yuntsebaryon/AtlasScientificSensorArduino/(list of files, drawings)

Other design files:
PCB/TeensyHumO2TC/freerouting.dsn
PCB/TeensyHumO2TC/temp-freerouting.dsn
