yuntsebaryon/AtlasScientificSensorArduino/PCB/TeensyHumO2TC/TeensyHumO2TC.kicad_pcb

## KiCad design PCB/TeensyHumO2TC/TeensyHumO2TC.kicad_pcb (2023-09-07)

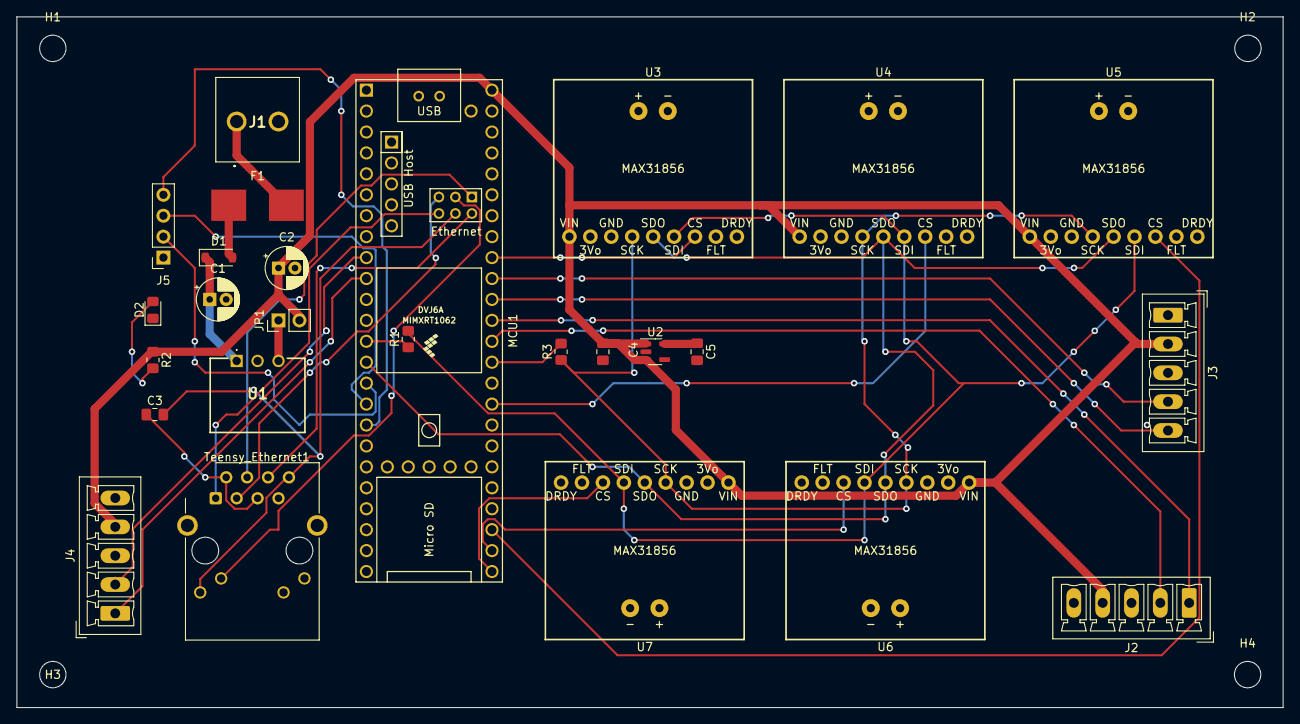
[picture p1: board TeensyHumO2TC.kicad_pcb from above]

Board: 2 copper layers, 153.7 x 83.8 mm, 30 parts (0 on the bottom side), 28 nets.

Parts:
C1: 10u; CP_Radial_D5.0mm_P2.00mm
C2: 22u; CP_Radial_D5.0mm_P2.00mm
C3: 100n; C_0805_2012Metric_Pad1.18x1.45mm_HandSolder
C4, C5: 1u; C_0805_2012Metric_Pad1.18x1.45mm_HandSolder
D1: D; D_SOD-123
D2: LED 5VOK; LED_0805_2012Metric_Pad1.15x1.40mm_HandSolder
F1: 1A; smd_fuse
H1, H2, H3, H4: MountingHole; MountingHole_3.2mm_M3_DIN965
J1: Screw_Terminal_01x02; TB00750802BE
J2, J3, J4: Conn_01x05_Socket; PhoenixContact_MCV_1,5_5-G-3.5_1x05_P3.50mm_Vertical
J5: OLED Display I2C; PinSocket_1x04_P2.54mm_Vertical
JP1: PS; PinHeader_1x02_P2.54mm_Vertical
MCU1: Teensy41
R1, R3: 22R; R_0805_2012Metric_Pad1.20x1.40mm_HandSolder
R2: 1.5k; R_0805_2012Metric_Pad1.20x1.40mm_HandSolder
Teensy_Ethernet1: RJ45_Cetus_J1B1211CCD_Horizontal
U1: N7805; N78051C
U2: NCP163ASN330T1G; SOT-23-5
U3, U4, U5, U6, U7: thermo_max31856; MAX31856

Connections:
+3.3VA: C5.1, U2.5 (VOUT)
+5V: C2.1, C4.1, J2.4, J3.2, J4.4, JP1.2 (B), MCU1.48 (VIN), R2.1, U2.1 (VIN), U2.3 (EN), U3.1 (VIN), U4.1 (VIN), U5.1 (VIN), U6.1 (VIN), U7.1 (VIN)
/CLK: R3.1, U3.4 (SCK), U4.4 (SCK), U5.4 (SCK), U6.4 (SCK), U7.4 (SCK)
/CS_1: MCU1.40 (18_A4_SDA), U3.7 (CS)
/CS_2: MCU1.33 (41_A17), U4.7 (CS)
/CS_3: MCU1.27 (35_TX8), U5.7 (CS)
/CS_4: MCU1.26 (34_RX8), U6.7 (CS)
/CS_5: MCU1.25 (33_MCLK2), U7.7 (CS)
/SDI: R1.2, U3.6 (SDI), U4.6 (SDI), U5.6 (SDI), U6.6 (SDI), U7.6 (SDI)
/SDO: MCU1.14 (12_MISO_MQSL), U3.5 (SDO), U4.5 (SDO), U5.5 (SDO), U6.5 (SDO), U7.5 (SDO)
GND: C1.2, C2.2, C4.2, C5.2, D2.1 (K), J1.2, J2.3, J2.5, J3.1, J3.3, J4.3, J4.5, J5.1, MCU1.47 (GND), U1.2 (GND/-Vout), U2.2 (GND), U3.3 (GND), U4.3 (GND), U5.3 (GND), U6.3 (GND), U7.3 (GND)
I2C_SCL: J5.3, MCU1.16 (24_A10_TX6_SCL2)
I2C_SDA: J5.4, MCU1.17 (25_A11_RX6_SDA2)
unnamed: C3.1, Teensy_Ethernet1.2, Teensy_Ethernet1.5
unnamed: C3.2, MCU1.64 (GND), Teensy_Ethernet1.8, Teensy_Ethernet1.9
unnamed: D1.2 (A), F1.1
unnamed: C1.1, D1.1 (K), U1.1 (IN)
unnamed: D2.2 (A), R2.2
unnamed: F1.2, J1.1
unnamed: J5.2, MCU1.15 (3V3)
unnamed: JP1.1 (A), U1.3 (+Vout/GND)
unnamed: MCU1.13 (11_MOSI_CTX1), R1.1
unnamed: MCU1.35 (13_SCK_LED), R3.2
unnamed: MCU1.61 (LED), Teensy_Ethernet1.10
unnamed: MCU1.60 (R+), Teensy_Ethernet1.4
unnamed: MCU1.65 (R-), Teensy_Ethernet1.6
unnamed: MCU1.63 (T+), Teensy_Ethernet1.1
unnamed: MCU1.62 (T-), Teensy_Ethernet1.3
