yuntsebaryon/AtlasScientificSensorArduino/PCB/HumidityO2/HumidityO2.kicad_pcb

## KiCad design PCB/HumidityO2/HumidityO2.kicad_pcb (2023-05-11)

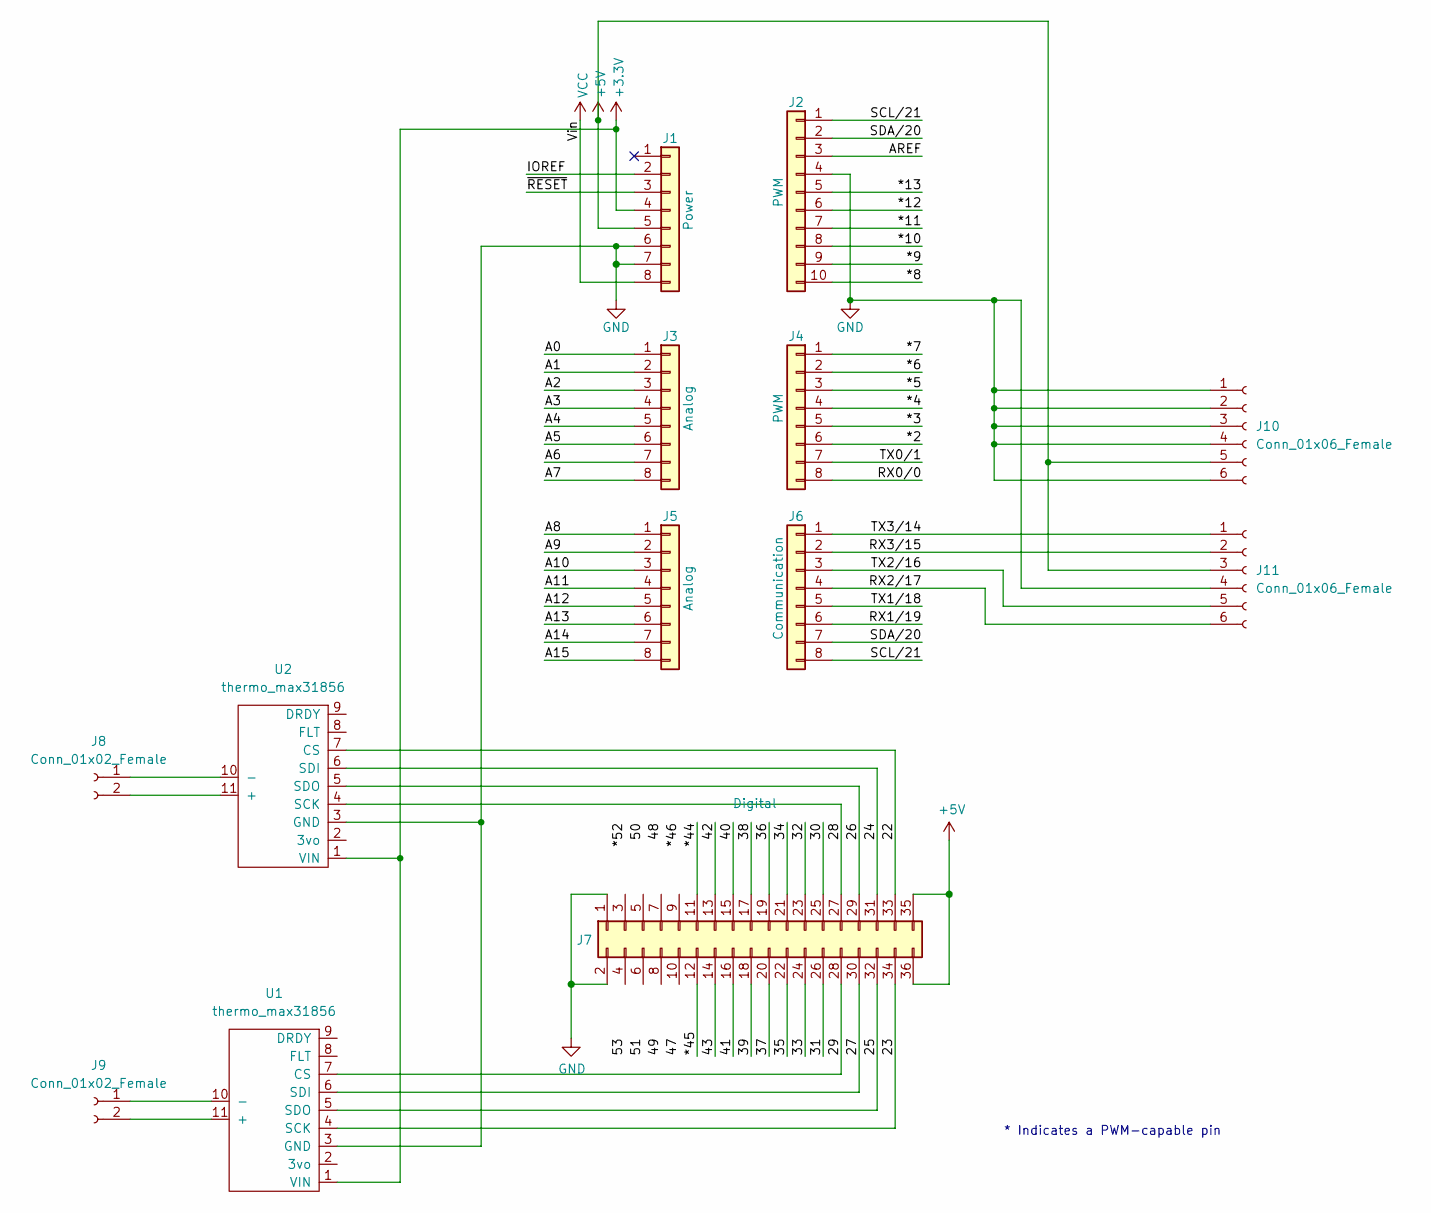
[picture p2: schematic HumidityO2.kicad_sch]

Parts:
J1: Power; PinSocket_1x08_P2.54mm_Vertical
J2: PWM; PinSocket_1x10_P2.54mm_Vertical
J3, J5: Analog; PinSocket_1x08_P2.54mm_Vertical
J4: PWM; PinSocket_1x08_P2.54mm_Vertical
J6: Communication; PinSocket_1x08_P2.54mm_Vertical
J7: Digital; PinSocket_2x18_P2.54mm_Vertical
J8, J9: Conn_01x02_Female; PhoenixContact_MCV_1,5_2-G-3.5_1x02_P3.50mm_Vertical
J10, J11: Conn_01x06_Female; PhoenixContact_MCV_1,5_6-G-3.5_1x06_P3.50mm_Vertical
U1, U2: thermo_max31856; MAX31856

Connections:
+3V3: J1.4, U1.1 (VIN), U2.1 (VIN)
+5V: J1.5, J7.35, J7.36, J10.5, J11.3
/22: J7.33, U2.7 (CS)
/23: J7.34, U1.4 (SCK)
/24: J7.31, U2.6 (SDI)
/25: J7.32, U1.5 (SDO)
/26: J7.29, U2.5 (SDO)
/27: J7.30, U1.6 (SDI)
/28: J7.27, U2.4 (SCK)
/29: J7.28, U1.7 (CS)
/30: J7.25
/31: J7.26
/32: J7.23
/33: J7.24
/34: J7.21
/35: J7.22
/36: J7.19
/37: J7.20
/38: J7.17
/39: J7.18
/40: J7.15
/41: J7.16
/42: J7.13
/43: J7.14
/*2: J4.6
/*3: J4.5
/*4: J4.4
/*5: J4.3
/*6: J4.2
/*7: J4.1
/*8: J2.10
/*9: J2.9
/*10: J2.8
/*11: J2.7
/*12: J2.6
/*13: J2.5
/*44: J7.11
/*45: J7.12
/A0: J3.1
/A1: J3.2
/A2: J3.3
/A3: J3.4
/A4: J3.5
/A5: J3.6
/A6: J3.7
/A7: J3.8
/A8: J5.1
/A9: J5.2
/A10: J5.3
/A11: J5.4
/A12: J5.5
/A13: J5.6
/A14: J5.7
/A15: J5.8
/AREF: J2.3
/IOREF: J1.2
/RX0/0: J4.8
/RX1/19: J6.6
/RX2/17: J6.4, J11.6
/RX3/15: J6.2, J11.2
/SCL/21: J2.1, J6.8
/SDA/20: J2.2, J6.7
/TX0/1: J4.7
/TX1/18: J6.5
/TX2/16: J6.3, J11.5
/TX3/14: J6.1, J11.1
/~RESET: J1.3
GND: J1.6, J1.7, J2.4, J7.1, J7.2, J10.1, J10.2, J10.3, J10.4, J10.6, J11.4, U1.3 (GND), U2.3 (GND)
unnamed: J8.1, U2.10 (-)
unnamed: J8.2, U2.11 (+)
unnamed: J9.1, U1.10 (-)
unnamed: J9.2, U1.11 (+)
VCC: J1.8

Notes on the sheet:
* Indicates a PWM-capable pin

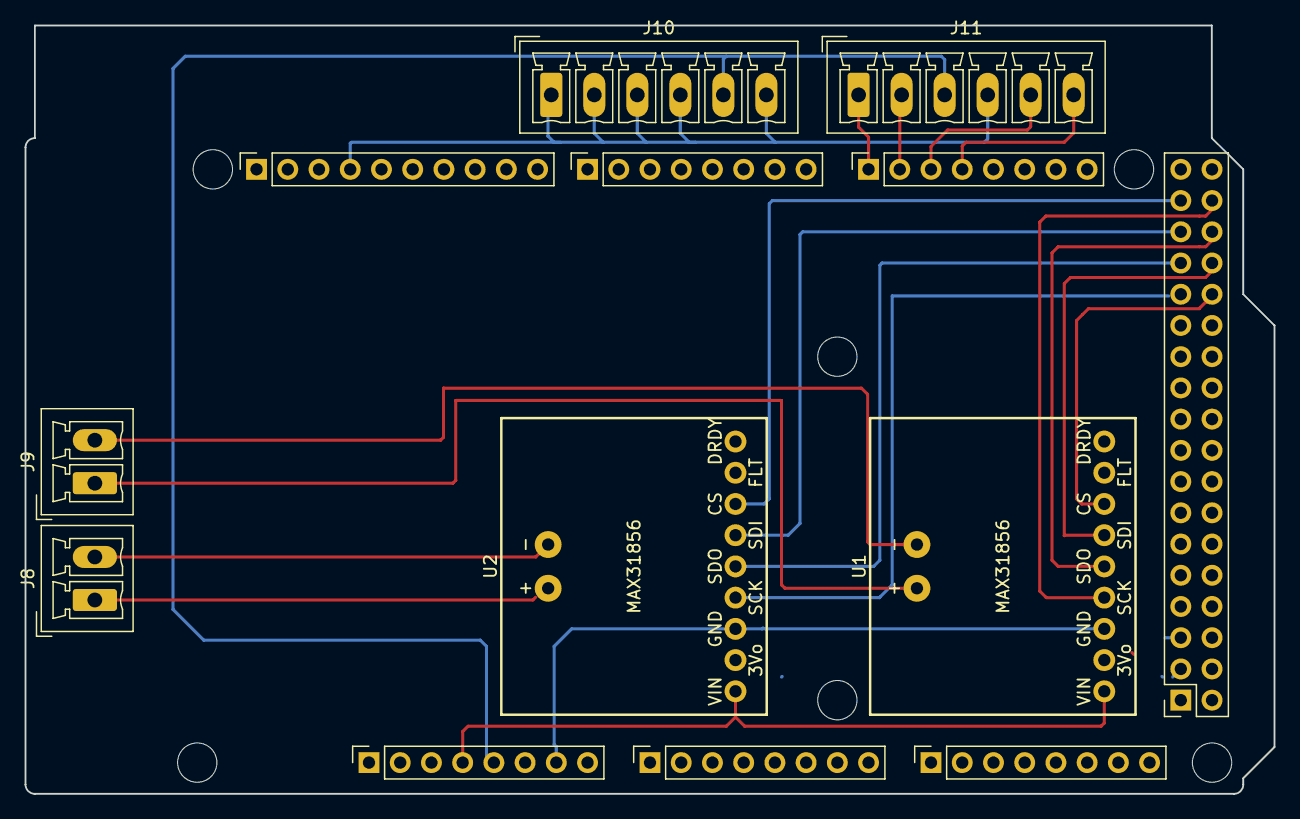
[picture p3: board HumidityO2.kicad_pcb from above]

Board: 2 copper layers, 101.6 x 62.5 mm, 19 parts (0 on the bottom side), 21 nets.

Other parts of the board:
MH1, MH2, MH3, MH4, MH5, MH6: MountingHole_3.2mm
