yuntsebaryon/AtlasScientificSensorArduino/O2/arduino_UNO_O2_modbus/arduino_UNO_O2_modbus.ino

//This code was written to be easy to understand.
//Modify this code as you see fit.
//This code will output data to the Arduino serial monitor.
//Type commands into the Arduino serial monitor to control the EZO-o2 sensor.
//This code was written in the Arduino 1.8.12 IDE
//An Arduino UNO was used to test this code.
//This code was last tested 6/2020



#include <SoftwareSerial.h>                           //we have to include the SoftwareSerial library, or else we can't use it
#define rx 2                                          //define what pin rx is going to be
#define tx 3                                          //define what pin tx is going to be

SoftwareSerial myserial(rx, tx);                      //define how the soft serial port is going to work

// Ethernet libraries
#include <SPI.h>
#include <Ethernet.h>

#include <ArduinoRS485.h> // ArduinoModbus depends on the ArduinoRS485 library
#include <ArduinoModbus.h>


String inputstring = "";                              //a string to hold incoming data from the PC
String sensorstring = "";                             //a string to hold the data from the Atlas Scientific product
boolean input_string_complete = false;                //have we received all the data from the PC
boolean sensor_string_complete = false;               //have we received all the data from the Atlas Scientific product
float o2;                                             //used to hold a float number that is the o2


// Set up MAC address and IP
byte mac[] = {0xDE, 0xAD, 0xBE, 0xEF, 0xFE, 0xED};
IPAddress ip(172, 21, 103, 34);
IPAddress netmask(255, 255, 254, 0);
IPAddress gateway(172, 21, 102, 1);

EthernetServer ethServer(502);
ModbusTCPServer modbusTCPServer;


void setup() {                                        //set up the hardware
  Serial.begin(9600);                                 //set baud rate for the hardware serial port_0 to 9600
  myserial.begin(9600);                               //set baud rate for the software serial port to 9600
  inputstring.reserve(10);                            //set aside some bytes for receiving data from the PC
  sensorstring.reserve(30);                           //set aside some bytes for receiving data from Atlas Scientific product

  Ethernet.begin(mac, ip);                            // Set up the ethernet
  Ethernet.setSubnetMask(netmask);
  Ethernet.setGatewayIP(gateway);

  // Check for Ethernet hardware present
  if (Ethernet.hardwareStatus() == EthernetNoHardware) {
    Serial.println("Ethernet shield was not found.  Sorry, can't run without hardware. :(");
    while (true) {
      delay(1); // do nothing, no point running without Ethernet hardware
    }
  }
  if (Ethernet.linkStatus() == LinkOFF) {
    Serial.println("Ethernet cable is not connected.");
  }

  Serial.print("My IP address: ");
  Serial.println(Ethernet.localIP());

  // start the server
  ethServer.begin();

  // start the Modbus TCP server
  if (!modbusTCPServer.begin()) {
    Serial.println("Failed to start Modbus TCP Server!");
    while (1);
  }

  // configure input registers at address 0x00

  modbusTCPServer.configureInputRegisters(0x00,6);

}


void serialEvent() {                                  //if the hardware serial port_0 receives a char
  inputstring = Serial.readStringUntil(13);           //read the string until we see a <CR>
  input_string_complete = true;                       //set the flag used to tell if we have received a completed string from the PC
}


void loop() {                                         //here we go...

  EthernetClient client = ethServer.available();
  
  if (client) {
    // a new client connected
    // Serial.println("new client");

    // let the Modbus TCP accept the connection 
    modbusTCPServer.accept(client);
    if (client.connected()) {
      // poll for Modbus TCP requests, while client connected
      modbusTCPServer.poll();
    }
  }


  if (input_string_complete == true) {                //if a string from the PC has been received in its entirety
    myserial.print(inputstring);                      //send that string to the Atlas Scientific product
    myserial.print('\r');                             //add a <CR> to the end of the string
    inputstring = "";                                 //clear the string
    input_string_complete = false;                    //reset the flag used to tell if we have received a completed string from the PC
  }

  if (myserial.available() > 0) {                     //if we see that the Atlas Scientific product has sent a character
    char inchar = (char)myserial.read();              //get the char we just received
    sensorstring += inchar;                           //add the char to the var called sensorstring
    if (inchar == '\r') {                             //if the incoming character is a <CR>
      sensor_string_complete = true;                  //set the flag
    }
  }


  if (sensor_string_complete == true) {               //if a string from the Atlas Scientific product has been received in its entirety
    Serial.println(sensorstring);                     //send that string to the PC's serial monitor
                                                    //uncomment this section to see how to convert the o2 readings from a string to a float
    if (isdigit(sensorstring[0])) {                   //if the first character in the string is a digit
      o2 = sensorstring.toFloat();                    //convert the string to a float so it can be evaluated by the Arduino
      /*
      if (o2 >= 22) {                                 //if the o2 is greater than or equal to 22%
        Serial.println("high");                       //print "high" this is demonstrating that the Arduino is evaluating the o2 as a number and not as a string
      }
      if (o2 <= 20.95) {                              //if the o2 is less than or equal to 20.95%
        Serial.println("low");                        //print "low" this is demonstrating that the Arduino is evaluating the o2 as a number and not as a string
      }
      */
    }
    
    sensorstring = "";                                //clear the string
    sensor_string_complete = false;                   //reset the flag used to tell if we have received a completed string from the Atlas Scientific product
  }

  uint8_t reg = 0;
  modbusTCPServer.inputRegisterWrite(reg++, (uint16_t) (o2*100));  
}
