yuntsebaryon/AtlasScientificSensorArduino/(commit log)

2022-08-07 the O2 has the original sample code, while the humidity I added a couple of lines for the input string
2022-08-11 add arduino mega for humidity sensors, reoragnize the directories
2022-08-24 read both the humidity and O2 sensors
2022-08-24 add sample code and modbus code
2023-05-11 new pins, add PCB drawing
    [HumidityO2.kicad_pcb, HumidityO2.kicad_sch]
2023-08-03 new code for teensy
2023-08-21 new code to measure the humidity, oxygen, temperature, and display the value. also it sends the information via the serial port and daq/teensy_daq.py creates a csv file for the data
2023-08-21 complete the doc and slightly adjust the order of serial prints in the code
2023-09-07 clean up
    [TeensyHumO2TC.kicad_pcb, TeensyHumO2TC.kicad_sch, freerouting.dsn, temp-freerouting.dsn]
2023-10-03 fix the dynamic range issue, also use int16_t instead of uint16_t
    [teensy_humidity_O2_TC_eth.ino]
